sinara-hw/DIO_BNC/(list of files, drawings)

Other design files:
DIO-BNC.PrjPCB
DIO-BNC.schdoc
DIO-BNC_CH0-3.schdoc
DIO-BNC_CH4-7.schdoc
DIO-BNC_Supply.SchDoc
