sinara-hw/DIO_BNC/(threads)

Thread 1 (2018-06-13):

DIO BNC v1.2 errata

marmeladapk, 2018-06-13:
_From @gkasprow on [2018-03-08 12:24](https://github.com/sinara-hw/sinara/issues/527)_

- [x] make panel holes for BNC connectors smaller - the screw size is 10.3mm but hole is 13mm.
The same applies to Sampler panel.
- [x] swap channels 4/5 and 6/7 (J3 with J4)
- [x] fix LED order - in channels: 2/3 4/5 6/7 top LEDs are swapped with bottom ones

gkasprow, 2018-07-30:
Datasheet says that the PCB hole should be 12.15mm.

Closed 2018-07-30.

Thread 3 (2018-07-30):

regulator direction

hartytp, 2018-07-30:
Really minor issue, but can you flip the 5V regulators around on the schematic so that Pin is on the left and Pout on the right, please? That seems much more normal

gkasprow, 2018-08-04:
done

Closed 2018-08-04.

Thread 4 (2018-08-08):

Add resistors

hartytp, 2018-08-08:
@gkasprow since this board can be used as both an input to the ADC and as an output from the DAC, it might make sense to have a series 0R input resistor on each side of the capacitor.

Also, not sure if this makes sense or not, but we could add a DNF resistor in parallel with the capacitor in case anyone wanted to add an attenuator. It's a low priority, but might come in use. If you don't think it's worth it then don't bother :)

hartytp, 2018-08-08:
Oops, wrong design!

hartytp, 2018-09-06:
@gkasprow has this been done? Can we close this issue?

gkasprow, 2018-09-06:
yes

Closed 2018-09-06.

Thread 5 (2018-09-25):

direction control over I2C

gkasprow, 2018-09-25:
@jordens is direction control over I2C implemented?
Tom Walker reports that direction readout works, he can also control it via DIP switch. But when he tries to set it from ARTIQ it does not work.

taw181, 2018-09-25:
To expand on this, the dashboard reads In or Out correctly when setting DIP switch or using TTLInOut.output() or .input(), but I can't output TTL high either via on() or OVR + LVL on dashboard when the switch is set to In. I can output TTL high when the DIP switch is set to out.

hartytp, 2018-09-25:
> To expand on this, the dashboard reads In or Out correctly when setting DIP switch or using TTLInOut.output() or .input(), but I can't output TTL high either via on() or OVR + LVL on dashboard when the switch is set to In. I can output TTL high when the DIP switch is set to out.

Moninj doesn't currently touch the I2C bus that controls the TTL direction.

TTL.{output, input} control the LVDS interface on Kasli, *not* the buffer on the DIO board.

hartytp, 2018-09-25:
See https://github.com/m-labs/artiq/blob/20cddb6a2505ec943592abd515f7373e53331396/artiq/gateware/rtio/phy/ttl_simple.py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

jordens, 2018-09-25:
It's not implemented in ARTIQ. The dashboard doesn't know anything about the I2C direction control or DIP switch settings. If you have code, you should clean it up and post it for review.
IIRC I tested the basic functionality of the I2C direction control a while back.

If implemented, this would also hook into https://github.com/m-labs/artiq/issues/823

Thread 6 (2018-10-01):

BNC hole too small

gkasprow, 2018-10-01:
change dimension of the BNC hole, 12.5 -> 13mm

gkasprow, 2020-07-02:
done

Closed 2020-07-02.

Thread 7 (2019-08-07):

isolation jumpers

hartytp, 2019-08-07:
The desire to have the IO isolated came from older systems where all control hardware shares a common ground. Now Kasli + DRTIO works well, this seems to be less important; it's generally easy to have sub-sections of the experiment that require different grounds running from different Kaslis, with DRTIO fibres providing isolation. Cases where 1-2 IOs need a completely separate ground do still exist, but seem much less common.

Isolating grounds like this has some gotchas, and is probably not a good default option. I can see two paths forward:
1. Make new versions of the IO boards without the ioslation
2. Add populated-by-default jumpers to the next revision of these boards, which tie the grounds together.

My preference would be 2 because

Pros:
- Trivial change to existing design, much less work/risk of breakage than ripping out the isolators and creating a new design. In the current design, we already have R19 and R25 that can be used to break the isolation (replace with 0R). However, having a jumper seems nicer (no soldering required, and visually easier to see what's happening) and shorting the grounds together by default seems like a good idea.
- Easy to switch between isolation and non-isolation to investigate ground loops

Cons:
- Marginally more expensive (need extra isolators etc). Doesn't really concern me since the cost increase is small and probably swamped by batch size etc (i.e. producing more each of fewer designs probably cheaper)
- More complicated. Again, fewer designs means each is likely to be more widely used, better tested/documented etc, which for me outweighs a small increase in complexity
- More latency/jitter. IIRC the jitter we measured was a few hundred ps, which should be fine for most applications (applications needing much less jitter should probably consider using stamper etc). Also, the jitter was a few times larger than the specified jitter from the isolator, so not clear how much removing it will win us.
- hidden state: one thing I like about Sinara is that almost all state (switches open/closed, terminators, etc) can be seen either from FP LEDs or from diagnostics (SCPI etc). This makes fault-finding etc much nicer. Having state (isolation/no isolation) that cannot be checked without removing PCBs from the rack concerns me. Not sure what the best solution to this is.

Thoughts?

jordens, 2019-08-07:
Yes. We need a low-jitter, non-isolated, cheap, high-density, low-EEM-count DIO solution.

IIRC the jitter was pretty much the isolator value which was ~500ps RMS and thus very much comparable to the 1ns resolution. It would be great if we could resolve the jitter issue of the isolators at the same time. The non-isolated driver does not have to have that issue but merely jumpering ground would transplant it.

We already have a good non-isolated IO solution: Banker. Already for the usual number of DIOs (>= 24) Banker does not significantly differ in price and saves lots of EEM connectors and -- if desired -- front panel space.

hartytp, 2019-08-07:
> IIRC the jitter was pretty much the isolator value which was ~500ps RMS

The isolator is 350ps pk-pk, RMS is <100ps I believe

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

hartytp, 2019-08-07:
What jitter do you expect from the FPGA -> ribbon cable -> LVDS buffer -> LVDS-LVCMOS driver? I don't have a well-calibrated expectation for that (particularly the FPGA), but no point optimizing the isolator below the other jitter sources. There are also lower jitter isolators (by at least a factor of a few) if we really want, but good to be clear on our goals before altering designs.

> The non-isolated driver does not have to have that issue but merely jumpering ground would transplant it.

To be clear, you mean that jumpering across the isolator to tie the grounds together does not decrease the jitter?

>

We  already have a good non-isolated IO solution: Banker. Already for the  usual number of DIOs (>= 24) Banker does not significantly differ in  price and saves lots of EEM connectors and -- if desired -- front panel  space.

Is your point here that we should just not bother with the {BNC, SMA}_DIO boards here and everyone should use banker?

jordens, 2019-08-07:
I stand corrected on the isolator datasheet value. But you measured 750ps pk-pk in practice and given the design of the isolator I would expect the distribution to be mostly uniform and thus the RMS value to be not much less than 500ps.

> Currently, the jitter between a pair of TTLs is about 1.5ns pk-pk, so something like 750ps pk-pk jitter per TTL. AFAICT, this is dominated by the isolators.

https://github.com/sinara-hw/sinara/issues/222#issuecomment-377239127 etc

jordens, 2019-08-07:
The FPGA is in the 90ps range "bad" case output jitter IIRC (from the Urukul SYNC issue).
If we make a non-isolated option we should not make that non-isolated option as jittery as the isolated one.
IMO for applications from 24 non-isolated channels upwards Banker looks to be a better solution than three or more DIO modules. I'm not saying that everyone should use Banker or that the DIO modules should die. I'm fine with adding jumpers to the DIO modules. But I think a new non-isolated DIO version aims for a use case that could be better filled by Banker.

hartytp, 2019-08-07:
Thanks for digging that out.

So, we measured 1.5ns pk-pk jitter between a pair of TTLs. Assuming each TTL contributed half the pk-pk jitter, that's 750ps per TTL, which is still a factor of 2 greater than the specified max jitter. So, it's still not obvious to me that we can blame this on the isolator.

hartytp, 2019-08-07:
> IMO for applications from 24 non-isolated channels upwards Banker looks to be a better solution than three or more DIO modules. I'm not saying that everyone should use Banker or that the DIO modules should die. I'm fine with adding jumpers to the DIO modules. But I think a new non-isolated DIO version aims for a use case that could be better filled by Banker.

Okay.

I haven't really thought too much about Banker (or trade-offs in terms of update rates/latency for that design), so it may be that some of our use-cases would be better served by it. Did you measure jitter with Banker?

It seems like adding a jumper is a good idea anyway. Having some way of detecting the isolation state (FP LED/something on an I2C extender) would be nice if we do it.

hartytp, 2019-08-07:
> RMS value to be not much less than 500ps.

Assume that's a typo and you mean "not much less than 350ps"

jordens, 2019-08-07:
I didn't measure jitter with Banker.
Yes. The RMS of a 750ps wide uniform (underlying the triangular convolution of the two TTLs) distribution is 750ps/2/sqrt(3)=217ps.

hartytp, 2019-08-07:
> Yes. The RMS of a 750ps wide uniform (underlying the triangular convolution of the two TTLs) distribution is 750ps/2/sqrt(3)=217ps.

So, the 350ps pk of jitter specified by the isolator is ~100ps RMS. So, not too far off what one might expect from the FPGA and other jitter sources. i.e. on the basis of current evidence it looks like: (a) we're not currently limited by the isolator's jitter (b) the isolator's jitter is probably not that much worse than the FPGA etc (and IIRC there are a few other isolators with a factor ~2 less jitter).

tl;dr without further data, I don't think jitter is a strong reason to remove the isolator.

jordens, 2019-08-07:
IIRC the fpga jitter was also peak, I don't know about the speculation w.r.t not being limited by the isolator. But sure. Somebody should measure it.

gkasprow, 2019-08-08:
The isolators are supplied by DC/DC converters. I added LC filter but some ripples are still there and may impact the jitter.

gkasprow, 2019-08-16:
What about making a high density, 16-channel MCX board with low jitter, high-speed IOs?
Something like this:
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

gkasprow, 2019-08-16:
Banker is very limited because does not support DRTIO. Such a solution would enable 1ns timing resolution occupying only 4HP. This is essential when used in the CPCIS crate.

hartytp, 2019-08-16:
Sounds like a good idea

jordens, 2019-08-16:
That is not much of a limitation in practice. Banker doesn't need to support drtio. It can still give you full timing resolution by routing the eem signals to the desired ios dynamically.

gkasprow, 2019-08-16:
True, but it's unnecessary complexity and adds a jitter and delays that it's hard to control.
Anyway, if there is such a need, I can release such a board.

gkasprow, 2019-09-17:
Let's close it. I designed a 16channel IO MCX board without isolators. It should reduce jitter significantly.

Closed 2019-09-17.

Thread 8 (2019-08-07):

labelling

hartytp, 2019-08-07:
R18 and R25 are quite important. Worth silk screen to identify them, as well as an annotation ("High-impedance connection between grounds to prevent build-up of charge" or something like that).

Same goes for R34/R35 C6 and C5. Annotation would be something like ("Connects panel to circuit ground, remove to float grounds").

Without these annotations, it's obvious what these are for.

gkasprow, 2020-07-02:
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

Closed 2020-07-02.

Thread 9 (2019-08-07):

remove DNP SMPSs

hartytp, 2019-08-07:
Given that the Murata SMPS works nicely, while we had repeated failures with the other one, I suggest we completely remove the DNPd one from the schematic/layout in the next revision to clean things up a little.

gkasprow, 2019-08-08:
I'm afraid that Murata does not produce these converters anymore :(

gkasprow, 2020-07-02:
we need to use TMH1205S. We can keep the Murata footprint just in case somebody has a stock of these components

gkasprow, 2020-07-02:
we can also go for RKZ-1205S

gkasprow, 2020-07-02:
That's strange. I was sure I saw this product as not produced anymore.
But now it is active...

gkasprow, 2020-07-02:
They have a lead time somewhere in December 2020..

Closed 2020-07-02.

Thread 11 (2020-06-18):

DIO_BNC in 4HP/CPCIS

gkasprow, 2020-06-18:
The DIO_BNC can be easily migrated to 4HP already - I developed a single MCX adapter that can be installed in all EEM modules with BNC connectors. So far we have Sampler, DIO_BNC, and Zotino adapter.

However, the CPCIS routes 16 LVDS lanes to every slot.
To effectively use all lanes, I already developed DIO_MCX, it was produced and works.
I'm collecting ideas about the future of isolated DIO.
Shall we scrap DIO_SMA and DIO_BNC and replace with 16 channel isolated MCX version?
Shall we preserve the idea of isolated quad IOs? Or, higher granularity is needed?
Or, simply leave existing DIO_SMA, DIO_BNC(MCX), and make an adapter that uses only 8 LVDS lanes.
Yet another idea is to use existing EEM to CPCIS adapter but make a new revision of DIO_SMA and DIO_BNC(MCX) 160mm long. This is my favorite approach because it ensures backward compatibility and no additional RnD for the adapter board.
The Kasli and Kasli Zynq have enough slots for 12 x8LVDS slots. With Kasli CPCIS adapter we will route them to 8 CPCIS slots in such a way that some slots would be x16, some x8, and some of them configurable (x8 or x16). With ZUS+ system board, all CPCIS slots would be x16.
Eventually, we will make native CPCIS support to Kasli which will slightly lower its cost and improve robustness. Once we make the ZUS+ system board running with ARTIQ, we will probably scrap Kasli because the ZUS+ FPGA would cost nearly the same as Artix.

jordens, 2020-06-18:
IME the downsides to isolation are significant and the approach is so incomplete that it is rarely helpful. Doing direction on a finer basis would be helpful. Many setups waste 3 channels because they need one input.
160mm long dio board is ok with me. Better yet skip the phase where we need the cpcis adapter altogether.

gkasprow, 2020-06-18:
OK, so we would replace the 8 channel DIO_SMA and DIO_BNC with 16 channel individually isolated MCX IOs. I'd use an approach already implemented in DIO_MCX with upper mezzanine.
To lower the cost, one can always order a twice cheaper version without the upper mezzanine, with only 8 IOs. That's true, there is no real benefit of having EEM version of it since existing boards can be used...

hartytp, 2020-06-19:
> with 16 channel individually isolated MCX IOs

Echoing what @jordens said above, I think we should remove the isolators from this design. We can always produce a second design with isolators later on if someone really needs them, but I do not think they should be the default (and I don't think it's worth the complexity of having a design that can support both isolated and non-isolated modes).

Isolation is much less of a priority for me than it used to be, primarily due to the success of Kasli, DRTIO, etc. In the old days we used to have one mammoth control system with everything attached, which led to all kinds of grounding nightmares. Now we tend to have more of a "one ground" per Kasli model (the exception there being ADC inputs, which tend to come from far afield, but Sampler takes care of that nicely).

The isolators add complexity (floating supplies) and jitter and can also couple AC noise into the system in unexpected ways if one isn't careful. Better not to have them except in the few situations where they really are nececcary.

gkasprow, 2020-06-19:
@hartytp we already have 16channel MCX DIO up and running :)
CERN is also interested in individually isolated version.

dtcallcock, 2020-06-20:
> That's true, there is no real benefit of having EEM version of it since existing boards can be used...

Wouldn't making the 16x non-isolated MCX board 160mm for now would save having to keep an EEM and CPCIS version around?

> Better not to have them except in the few situations where they really are necessary.

Yeah, I have found having an isolated input for the PMT can be handy.  Kind of wish Kasli had one or two isolated SMA digital inputs on the front panel (perhaps as a little mezzanine board).

gkasprow, 2020-06-20:
@dtcallcock we already have [16xMCX ](https://github.com/sinara-hw/DIO_MCX/wiki) non-isolated 160mm EEM DIO
Together with an adapter, it works with CPCIS and.
If there is enough interest, I can make individually isolated 16channel DIO in 160mm EEM form factor.
Since we already have DIO-BNC and DIO-SMA, the plan is to make CPCIS version only.

hartytp, 2020-06-23:
> Kind of wish Kasli had one or two isolated SMA digital inputs on the front panel (perhaps as a little mezzanine board).

Isn't that "little mezzanine board" the DIO_SMA ? ;)

In all seriousness though, I think it's a feature of Kasli that it doesn't have this kind of thing: there isn't room on the FP for SMAs/D-types so they would have to be mezzanines and everyone wants something slightly different there (a few low-speed DACs, a few ADCs, isolated/non-isolated BNCs/etc). Rather than trying to create something to suite everyone we keep things modular and provide a wide array of EEMs to do the job. If you want something cheaper/different then it's pretty easy for any student to throw something together to serve your purposes...

BTW can't you float your PMT if ground loops are really an issue?

dtcallcock, 2020-06-23:
> Isn't that "little mezzanine board" the DIO_SMA ? ;)

Yes, that's the problem.  It seems like with the current design, most people are wasting 3 inputs.  It sounds even worse under CPCIS where I'd have to replace a 16-ch MCX card with a DIO_SMA I wouldn't otherwise want, just to get one isolated input.

I think you're saying this isn't a problem though as Sinara isn't trying to 'suite everyone'.  I think this's a reasonable standpoint if the solution makes the DIOs less modular/general in some other way.

> isn't room on the FP for SMAs/D-types so they would have to be mezzanines

It's just one or two SMAs, so actually I think a pigtail from the panel (where there is a bunch of room to the left of the SFP cages) to an MMCX or whatever on the board would actually work here - no mezzanine or risk of people demanding DACs.

I think the PMT input is a unique and special signal so having it go straight to the FPGA board isn't that unreasonable.  For non-ion-trap applications it can be considered just a general TRIG/SYNC input (probably useful in its own right).

However, I think Kasli has sailed now.  Just wanted to mention that it's a solution to the above.

> BTW can't you float your PMT if ground loops are really an issue?

In this case there was a HV supply involved so floating wasn't a (sensible) option.  Sure, there are other ways to fix it though.  I just bring it up as a time when having isolation was actually useful.

hartytp, 2020-06-23:
> I think you're saying this isn't a problem though as Sinara isn't trying to 'suite everyone'.
> I think this's a reasonable standpoint if the solution makes the DIOs less modular/general in some other way

My point is that Sinara favors modularity over optimizing for individual use-cases. It's easy to build hardware based on a wishlist from a small number of users and end up with something bloated (c.f. Sayma) that tries to be too much to too many people.

I think that the real success of Kasli is that it's completely minimal; just an FPGA with a tonne of IO broken out to sensible connectors, making minimal assumptions about how it's going to be used.

You're implying that a couple of isolated IO on FP SMAs is something that would be useful to most users of Kasli. I don't believe that to be the case (but would be happy to be corrected if you have data).

> It's just one or two SMAs, so actually I think a pigtail from the panel (where there is a bunch of
> room to the left of the SFP cages) to an MMCX or whatever on the board would actually work
> here - no mezzanine or risk of people demanding DACs.

IIRC there also aren't any spare pins on the FPGA (although I can't remember if that's still true after the changes on v2.0). If there were then I'd be much more in favor of e.g. adding an extra IDC header. People can then easily break them out to whatever they want (e.g. add an I2C DAC instead of the IO if that's more useful to them and they don't want 32 channels of Zotino).

> I think the PMT input is a unique and special signal so having it go straight to the FPGA board
> isn't that unreasonable. For non-ion-trap applications it can be considered just a general
> TRIG/SYNC input (probably useful in its own right).

I don't agree. Many (most?) Kaslis are slaves, not masters and don't connect to a PMT. TRIG/SYNC inputs are pretty rare in ARTIQ systems (I think we scrapped line triggers long ago since they slowed down our data acqusition rate unacceptably).

Again, my concern here is that you're thinking about/optimizing for an individual small-scale experiment rather than the very large range of uses that Sinara serves (admittedly, that would be much easier if the vast majority of users would actually make themselves heard here...).

> In this case there was a HV supply involved so floating wasn't a (sensible) option. Sure, there are
> other ways to fix it though. I just bring it up as a time when having isolation was actually useful.

Again, IMHO even if we did have an input on Kasli, it shouldn't be isolated. For all the reasons we've discussed elsewhere, that's not completely unproblematic and is a pretty niche use-case.

If we have spare pins then this feels like something that could be best served by a small IO mezzanine (can hang of the FP) that connects to Kasli from a ribbon cable.

dtcallcock, 2020-06-23:
> Many setups waste 3 channels because they need one input.

This was the original point I was responding to (and is presumably based on data given @jordens is in the crate selling business).  If we don't want to address it on Kasli (and I see you _really_ don't want to do that), do we want to on DIO_BNC (which is after all what this tread is about)?

How about making the isolation Ch 0-1/2-7 instead of Ch0-3/4-7 and then doing the direction selection for every 2 channels instead of 4?  That would involve pretty minimal changes to the design.

jordens, 2020-06-23:
Imo it would be ok to change the dio boards to support just 1:7 or 0:8 in:out partitioning. I.e. only treat the first channel as special with optional input and optional termination. It would simplify a few things. That also matches the notion of having the first eem signal a clock-capable fpga pair.

dnadlinger, 2020-06-23:
1:7/0:8 only wouldn't work for our use case here – we have equal numbers of TTL inputs and outputs. Urukul (and DRTIO hardware in general) really reduce the need for bare TTL signals compared to traditional dumb-synth-plus-RF-switch-array-type setups.

hartytp, 2020-06-23:
Does having per-channel direction control add to the cost/complexity of the design in a noticeable way?

gkasprow, 2020-06-24:
@hartytp we already have per-channel direction control. The issue is to have per-channel isolation :)
The existing DIO16-MCX has also per-channel direction control but no isolation.

gkasprow, 2020-06-24:
We can add some uFL or MMCX connector + passive protection or buffer to the next Kasli revision. There are still 8 free IO pins. Then a low-cost SMA-UFL pigtail would do the job.

hartytp, 2020-06-24:
aah, sorry, yes.

@dnadlinger correct me if I'm wrong but we're not planning to use any isolated channels are we, so @jordens suggestion wouldn't be an issue for us...

gkasprow, 2020-06-24:
We plan to do design such an isolated board to popularize Sinara HW among the CERN users. They use a lot of isolated IOs for machine protection.

hartytp, 2020-06-24:
> We can add some uFL or MMCX connector + passive protection or buffer to the next Kasli revision. There are still 8 free IO pins. Then a low-cost SMA-UFL pigtail would do the job.

- If we're going to discuss this then we should discuss on Kasli not here
- I'd still prefer to reserve a couple of IO for future use. If we are going to break them out then a header seems to be a better way than an uFL/MMCX. It's still dirt cheap to use a ribbon cable to route to a tiny PCB that mates with the FP

dnadlinger, 2020-06-24:
@hartytp:

Robert wrote

> Imo it would be ok to change the dio boards to support just 1:7 or 0:8 in:out partitioning.

which would seem to refer to direction.

Switchable isolation would be fine, plus of course there could always be multiple variants in addition to the "standard" DIO-* modules.

hartytp, 2020-06-24:
Indeed, I think there has been some confusion in this thread over exactly what we're talking about.

IIU correctly the situation is that:
- this particular conversation doesn't relate to updating the existing EEMs, but rather to new CPICS DIO EEMs
- there is [already](https://github.com/sinara-hw/DIO_MCX) a 16-channel non-isolated DIO EEM with per-channel direction control. This is what I would consider the standard "standard" DIO choice for CPICs
- this discussion is about making an isolated equivalent

Isolation is something I consider somewhat niche and don't think we'll use heavily, so don't have strong opinions about the optimal partitioning between the grounds.

Obviously users should feel free to create any other variants they want. IME it's rarely worth it however. e.g. it's usually cheaper to be a bit wasteful using modules that are produced in high volumes than to get a custom module made that's exactly tailored to one's specific use-case. Fewer designs produced in higher volumes tends to result in lower overall costs and higher quality products IME

gkasprow, 2020-07-02:
nothing to do here, closing

Closed 2021-07-28.

Thread 12 (2020-06-30):

input protection

jordens, 2020-06-30:
Currently, input channels are limited by the -0.5 to 5.5 V abs max of the buffer. The body diode of the termination mosfet helps a bit with negative voltages below that. And there is also ESD protection.
We've seen latchup. Is there an easy way to protect the channels against a larger input voltage range? The bidirectional design is a bit of a hindrance here and the unused outputs look like they are most at risk.

* Applies also to DIO-SMA
* Also ties into the in-out partitioning and configurability of #11

gkasprow, 2020-07-02:
What about such circuit?
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

Closed 2020-07-03.

Thread 13 (2020-08-05):

DC/DC issue

gkasprow, 2020-08-05:
the RKZ-1205S which is an assembly option for NXE2S1205MC has an incompatible footprint. It is too long but can be assembled in an elevated way.

gkasprow, 2020-09-10:
TMH1205S is compatible

Closed 2022-01-19.

Thread 14 (2020-11-13):

Wiki: Input Signal Range

pathfinder49, 2020-11-13:
It'd be nice to add the working input voltage range to the wiki. From the SN74BCT25245DW datasheet, it looks like the working range is -0.5 to 5.5 V. (Though the upper limit drops to 5 V when the connection is set as output.)

The wiki also states:
> Max 150 MHz toggle rate with 50% duty cycle

I assume this applies to both input and output signals?

gkasprow, 2022-01-19:
Done
150MHz applies to both I and O.

Closed 2022-01-19.

Thread 16 (2022-01-19):

v1.6 resistors changes

filipswit, 2022-01-19:
Due to wrong resistive divider, enable of isolators and transceiver direction couldn't be changed. Resistors values are changed to:

<html>
<body>
<!--StartFragment-->

Des. | Value
-- | --
R45 | 3k9
R44 | 1k
R48 | 510
R56 | 470
R57 | 470
R50 | 3k9
R49 | 1k
R53 | 510
R58 | 470
R59 | 470

<!--EndFragment-->
</body>
</html>

gkasprow, 2022-01-19:
The LEDs must be connected to a dedicated MOSFET in the next revision to keep uniform brightness.

filipswit, 2022-01-19:
Yes, I was thinking about either MOSFET or buffer (kind of this: SN74AHCT1G125DBVT) after transoptor.

gkasprow, 2022-01-19:
let's not add things to the BOM. MOSFET is fine.

Closed 2022-05-04.

Thread 18 (2022-01-19):

v1.5 and v1.6 changelog

gkasprow, 2022-01-19:
v1.5
- added resistors + caps #15
v1.6
- due to chip shortages, assembly option for MAXIM isolator + an optocoupler was added

Thread 20 (2022-05-04):

DIO v1.6.1 changelog

gkasprow, 2022-05-04:
- reorganized schematics
- DC/DC converter replaced with available one
- added FETs to control LEDs #16

Thread 22 (2023-08-23):

IC30 EN pin voltage limit

MorganTL, 2023-08-23:
From the datasheet of IC30(AP62201WU-7), the maximum voltage allowed for the EN pin 6V. But in V1.6.1, the EN pin of IC30 is directly connected to the P12V0 which may damage the IC

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

gkasprow, 2023-08-23:
It's disconnected in 1.6.1 release. But I see the problem in repo. There is a missing DIO-BNC_Supply file in the sources and my version of 1.6.1 has this pin disconnected.The PCB file is OK.
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
So the sources are ok and the release is wrong.

gkasprow, 2023-08-23:
I updated the releases

gkasprow, 2023-08-23:
Just lift the pin 5 of the IC30 or cut the trace below the chip

gkasprow, 2023-08-23:
Cti produced 1.6.1 with pin floating :)

MorganTL, 2023-08-24:
I did a xor compare using the previous gerber files with the current release one and found that the track between EN and VIN pin is connected for the previous GTL gerber files. Also there's some changes to the GBL gerber (see attached).

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

Thread 26 (2025-08-28):

Add connect P3V3 enable to P3V3_MP

marmeladapk, 2025-08-28:
To prevent from P3V3 being enabled long before P3V3_MP.

On Kasli SoC P3V3 takes a while to bring up. This caused erratic behaviour from GPIO expander, which was powered through GPIO pins when DIR CTRL signals were pulled up to P3V3 while P3V3_MP was missing. Expander shorted DIR CTRL 1 to the ground and I was unable to control it using I2C or switches.

Connecting enable signal to P3V3 MP prevented this from happening.

Other solution might be to use a voltage translator to prevent one signal from being used in two power domains.
