sinara-hw/DIO_BNC/(commit log)

2018-08-06 v1.3 with panel grounding
    [DIO-BNC.schdoc, DIO-BNC_Supply.SchDoc]
2018-09-10 Updated PCB to production version
2021-07-28 v1.5rc1 fixed #15
    [DIO-BNC.PrjPCB, DIO-BNC.schdoc, DIO-BNC_Supply.SchDoc]
2022-01-19 sch version updated
    [DIO-BNC.schdoc, DIO-BNC_Supply.SchDoc]
2023-08-23 v1.6.1 - add missing files
    [DIO-BNC.PrjPCB, DIO-BNC.schdoc, DIO-BNC_Supply.SchDoc]
